chandanchirag07-art/Smart-Energy-Manager-ESP32/README.md

# Smart Energy Manager

## Overview

Smart Energy Manager is an IoT-based energy monitoring and protection system developed using ESP32 and PZEM-004T.

The system provides:

- Real-time monitoring of Voltage, Current, Power, Energy, Frequency and Power Factor
- Automatic Power Factor Correction (APFC)
- Over-voltage Protection
- Over-current Protection
- Emergency Kill Switch
- Cloud-based Monitoring using Blynk IoT
- Energy Cost Estimation and Reporting

## Hardware Used

- ESP32 Development Board
- PZEM-004T Energy Meter
- Relay Module
- Capacitor Bank
- AC Load
- Wi-Fi Network

## Software Used

- Arduino IDE
- Blynk IoT
- ESP32 Board Package

## Features

- Real-time Electrical Parameter Monitoring
- APFC Logic
- Remote Load Control
- Fault Latching Protection
- Mobile Dashboard
- Alert Notifications
- Billing Analytics

## Project Images

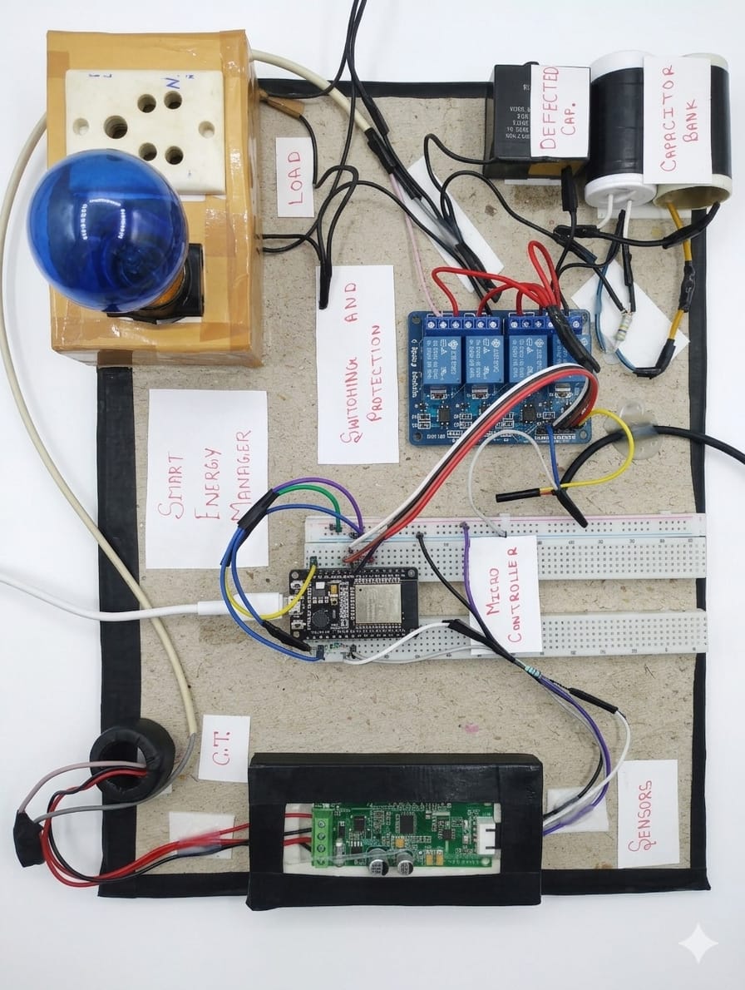
[picture p1: SEM_Project_Image.jpeg]
Smart Energy Manager


## Future Improvements

- MQTT Integration
- Three Phase Monitoring
- Cloud Database Storage
- Web Dashboard
- Load Forecasting

## Author

Chirag Chandan
B.Tech Electrical and Computer Engineering

## Project Demonstration

### Hardware Setup
Hardware

### Circuit Diagram
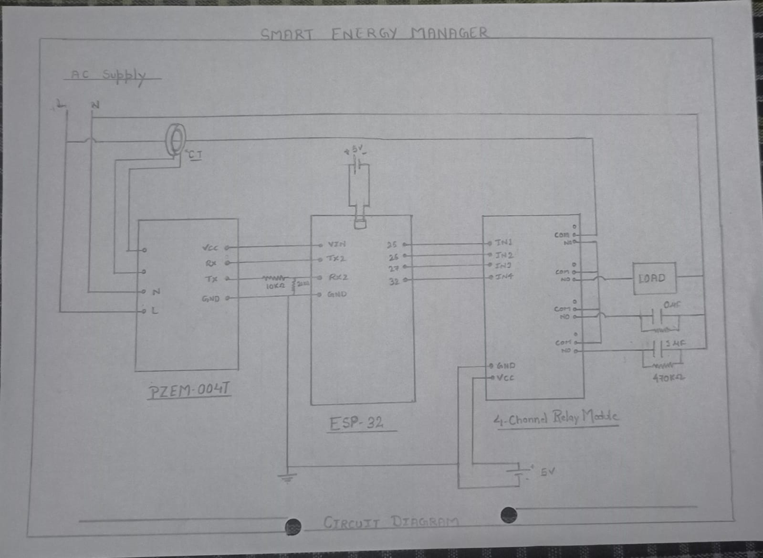
[picture p2: SEM_Circuit_Diagram.jpeg]
Circuit


### Dashboard
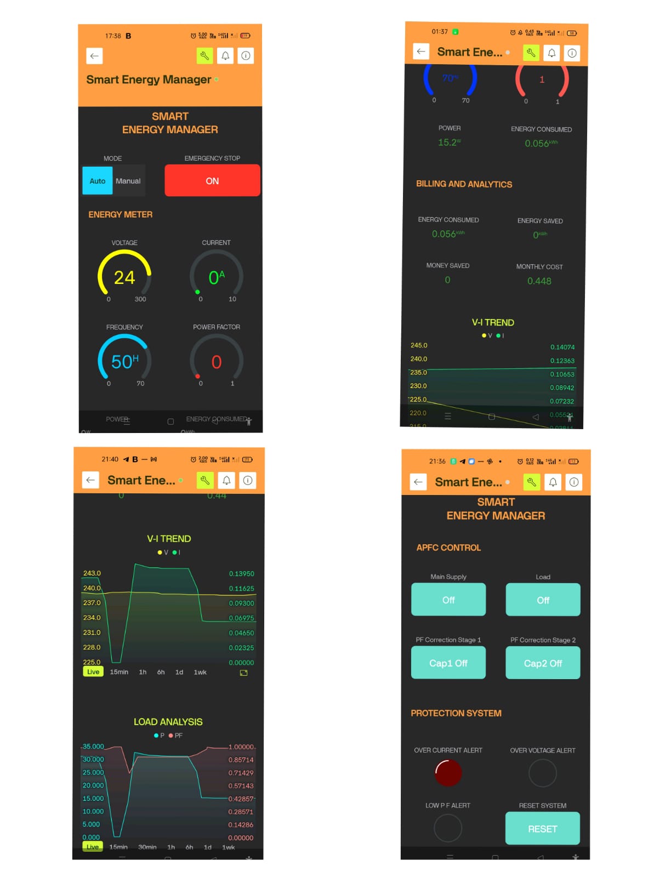
[picture p3: blynk_dashboard.jpeg]
Dashboard

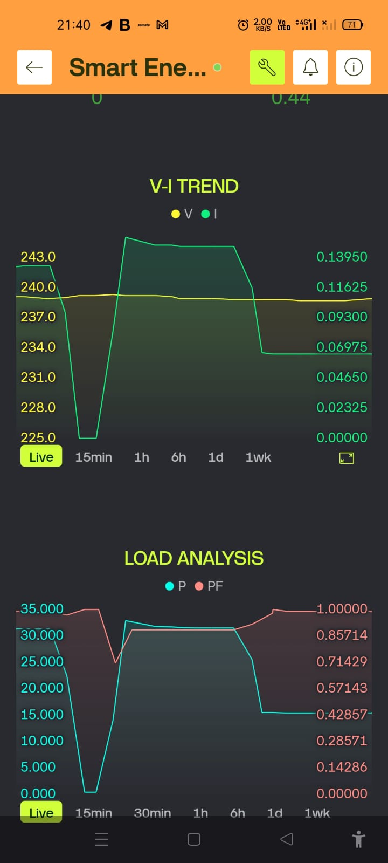
[picture p4: blynk_graph.jpeg]

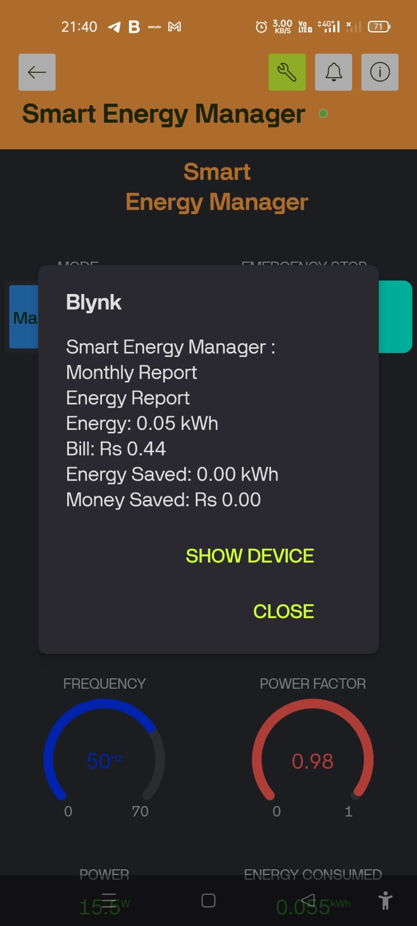
[picture p5: blynk_monthly_report.jpeg]

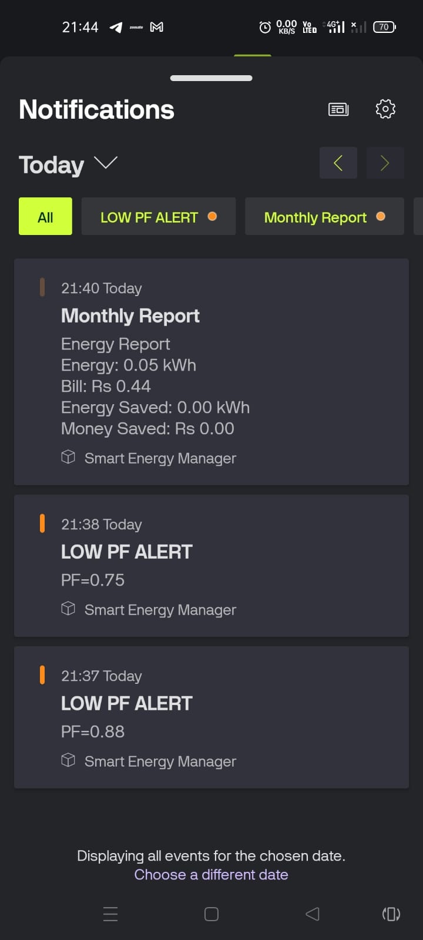
[picture p6: blynk_notification_alert.jpeg]
